andreitheclone/Voltage-Stabiliser/Layout/Layout.jpg

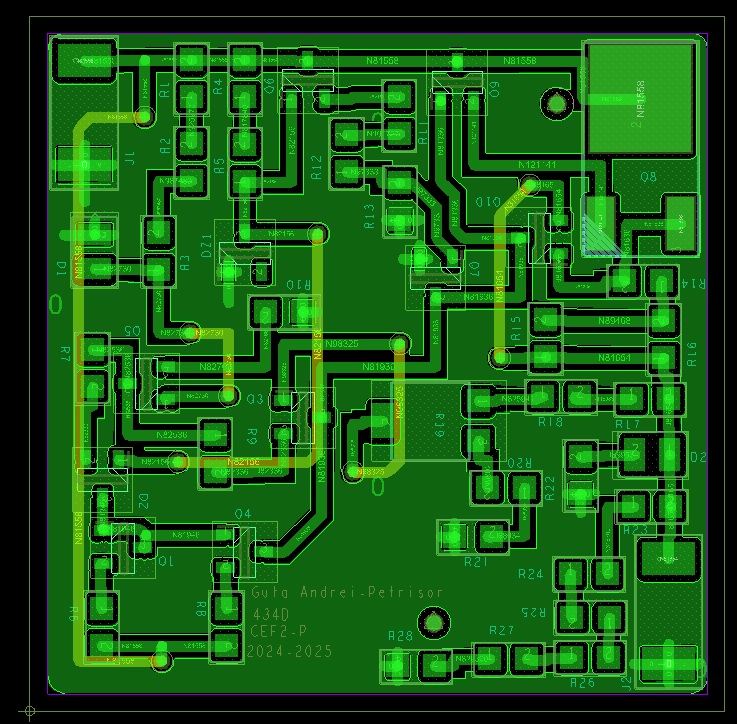
Layout/Layout.jpg
