andreitheclone/Voltage-Stabiliser/Proiect docs/Stabilizator de tensiune cu Element de Reglaj Serie.pdf

# Circuite electronice fundamentale 2 – Proiect Stabilizator de tensiune cu Element de Reglaj Serie (ERS)

Student: Guta Andrei-Petrisor Grupa: 434D

2024

## CUPRINS

1. Date initiale de proiectare
2. Schema bloc a montajului electric
3. Schema electrică a montajului
4. Simulări efectuate pentru a demonsta funcționarea schemei în parametrii impuși

### 1. Date initiale de proiectare

Tema proiectului: Se proiectează un stabilizator de tensiune cu element de reglaj serie cu următoarele caracteristici: N=13
- Tensiunea de ieșire reglabilă în intervalul: 6,5 - 13 [V]
- Element de reglaj serie;
- Sarcina la ieșire 520[Ω];
- Deriva termică < 2mV/⁰C;
- Protecție la suprasarcină prin limitarea temperaturii tranzistorului regulator serie la 120⁰C, si a curentului maxim la 0,5A;
- Tensiune de intrare în intervalul: 23,4 – 26 [V]
- Amplificarea în tensiune minimă (în buclă deschisă) a amplificatorului de eroare: minim 100;
- Domeniul temperaturilor de funcționare: 0⁰-60⁰C (verificabil prin testare în temperatură);
- Semnalizarea prezenței tensiunilor de intrare/ieșire cu diodă de tip LED.

### 2. Schema bloc a montajului electric

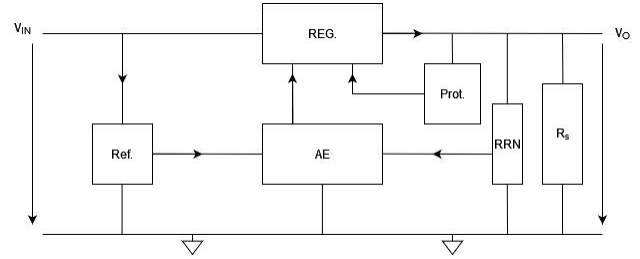
[picture p2: figure]

Ref. – Referința de tensiune
AE – Amplificatorul de eroare
REG. – Element reglaj serie
Prot. – Protecțiile la suprasarcină și termică RRN- Reacția negativă
RS- Impedanța de sarcină
- Referința de tensiune: Utilizeaza o diodă Zener pentru a stabiliza tensiunea de intrare, indiferent de diferiți parametri, cum ar fi sarcina, variațiile tensiunii de alimentare sau temperatura etc.
- Amplificatorul de eroare: Amplificatorul diferențial utilizează un amplificator neinversor cuplat la o oglinda de curent, care primește tensiunea de referință generate de dioda zenner pe intrarea neinversoare și o parte din tensiunea stabilizată pe intrarea inversoare prin intermediul retelei de reactie negativa.
- Reacția negativă: Reteaua de rezctie negative are rol in reglajul si mentinerea tensiunii de iesire. Primeste o parte din tensiunea de iesire pe care o redirectioneaza inapoi in amplificator pe intrarea inversoare. Pentru reglajul tensiunii de iesire este necesara utilizarea unui potentiometru.

- Element reglaj serie: Elementul reglaj serie este reprezentat de o punte Darlington formata din doua tranzistoare de putere care furnizează curent cu un anumit câștig către ieșire.
- Protectia termică și la suprasarcină: Asigură limitarea curentului și a temperaturii în intervalul de funcționare specificat

### 3. Schema electrică a montajului electric

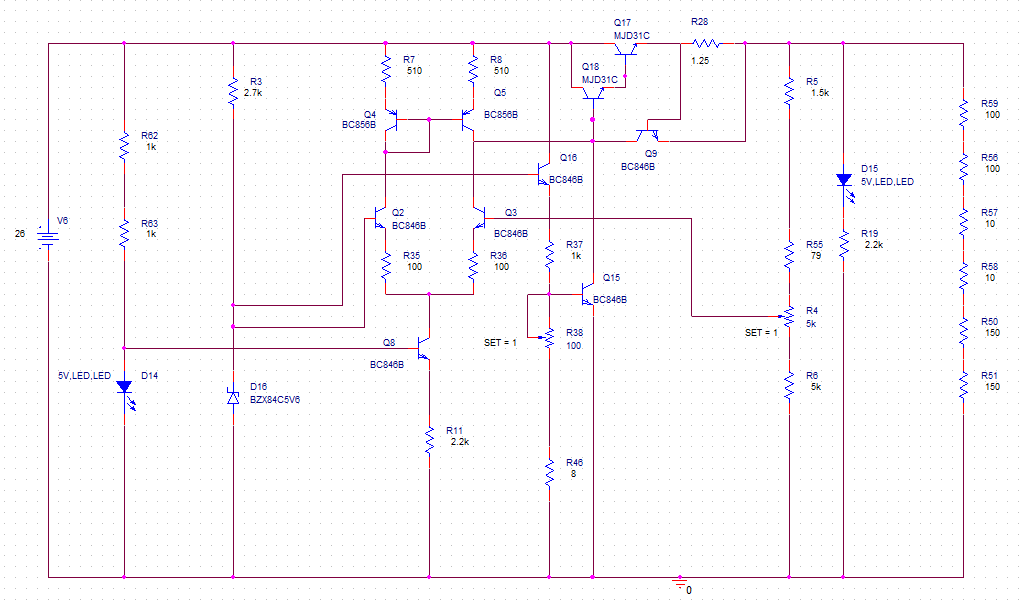
[picture p3: figure]

### 3.1. Conținut tehnic( calcul psf)

a. Referința de tensiune

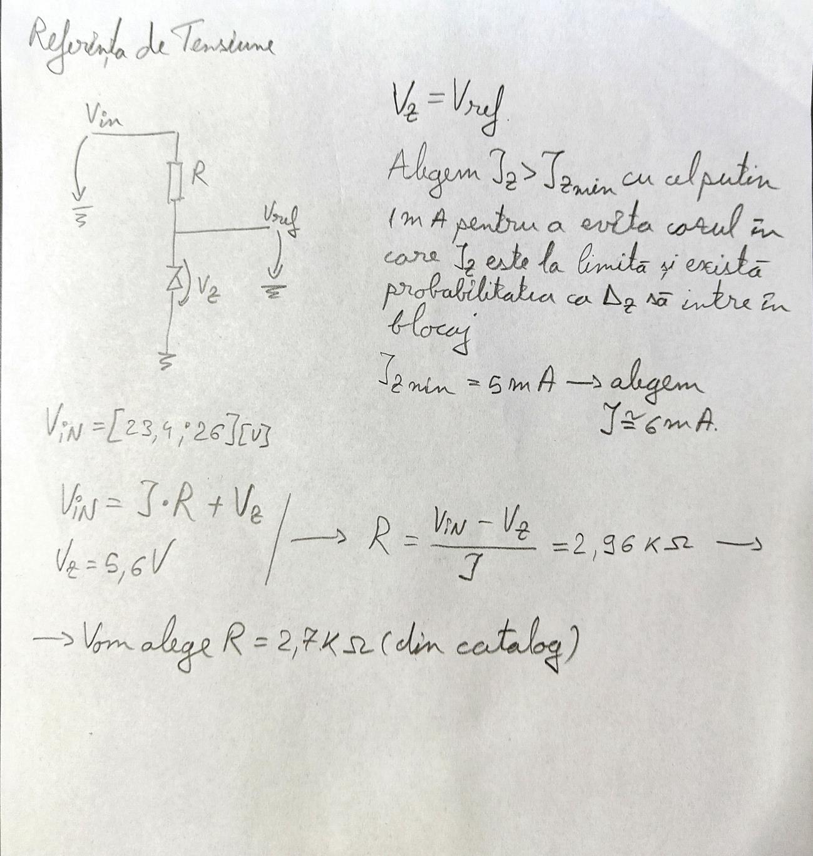
[picture p4: figure]

b. Amplificatorul de eroare

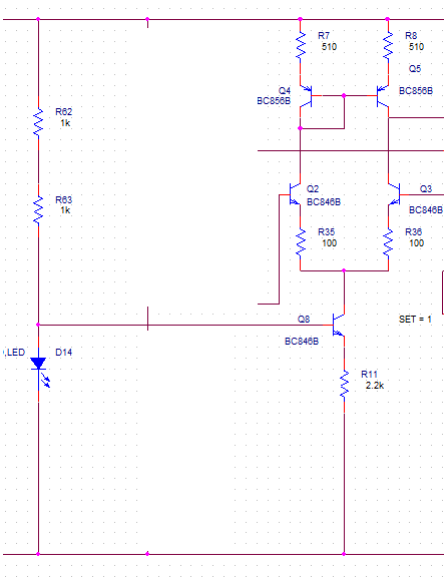
[picture p5: figure]

Amplificatorul de eroare are in componenta sa un generator de curent constant format din Q8, R62, R63 si D14(dioda led) vrea să tragă din amplificator un current de aproximativ 1 mA, astfel incat tranzistorul Q8 să funcționeze în RAN. IC2 + IC3 = IC8, dar VBE8 +R11*I=VD Rezultă R11=2.2kΩ. Se aleg tranzistoarele Q8, Q2 si Q3 de tip BC846B. Pentru echilibrul curenților din colectori IC2 și IC3, folosim oglinda de curent formată din Q4 și Q5 de tipul BC856B. Rezistorii R7 si R8 au rolul de a egaliza tensiunile baza-emitor a tranzistorilor din oglinda de curent realizată cu Q4 si Q5, de aceea R7 = R8 =510Ω.

c. Protecția la suprasarcină

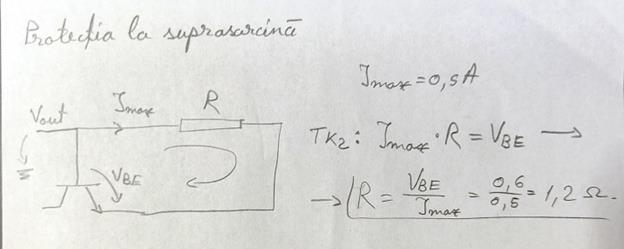
[picture p6: figure]

d. Reacția negative

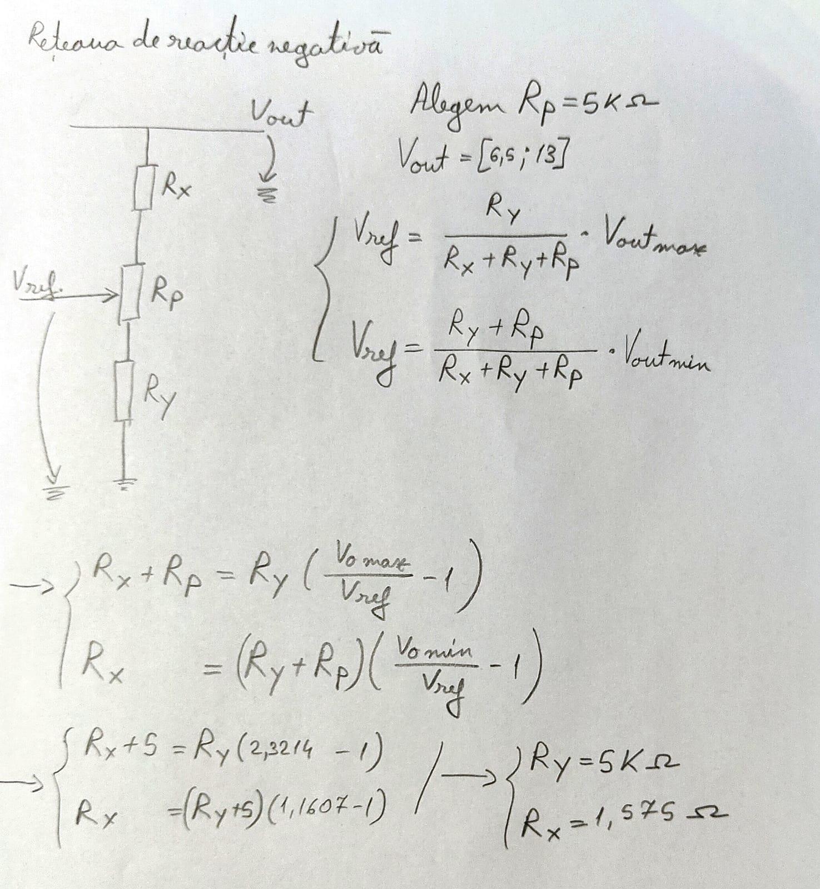
[picture p7: figure]

e. Element de reglaj serie

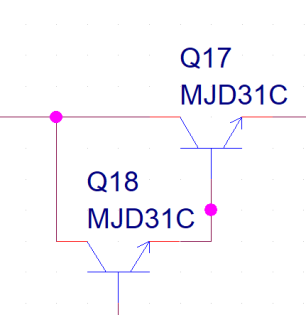
[picture p8: figure]

Utilizeaza doua tranzistoare de putere MJD31CG conectate in configuratie de punte Darlington.

### 3.2. Simulari PSF

Pentru a simula punctul static de funcționare se va ține cont de valorile tensiunilor de intrare 23.4-26V și de ieșire 6.5-13V, dar și de poziția potențiometrului (SET=0 sau SET=1). Astfel o să avem câte 4 tipuri de simulări pentru următoarele valori:

PSF- Tensiune
1. Vin=23.4 SET=0 Vout=13.00V

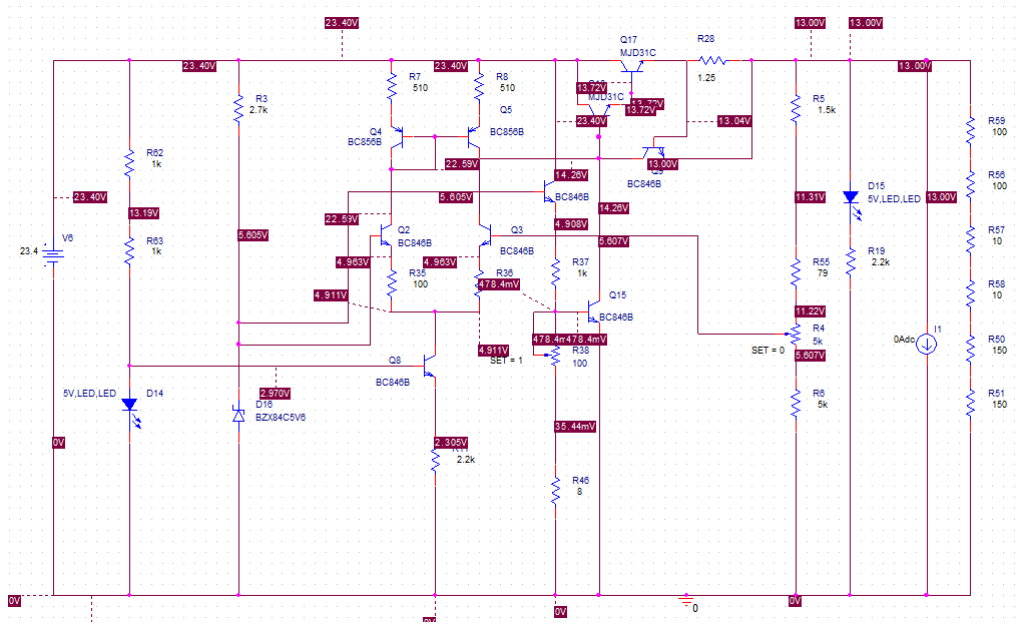
[picture p9: figure]
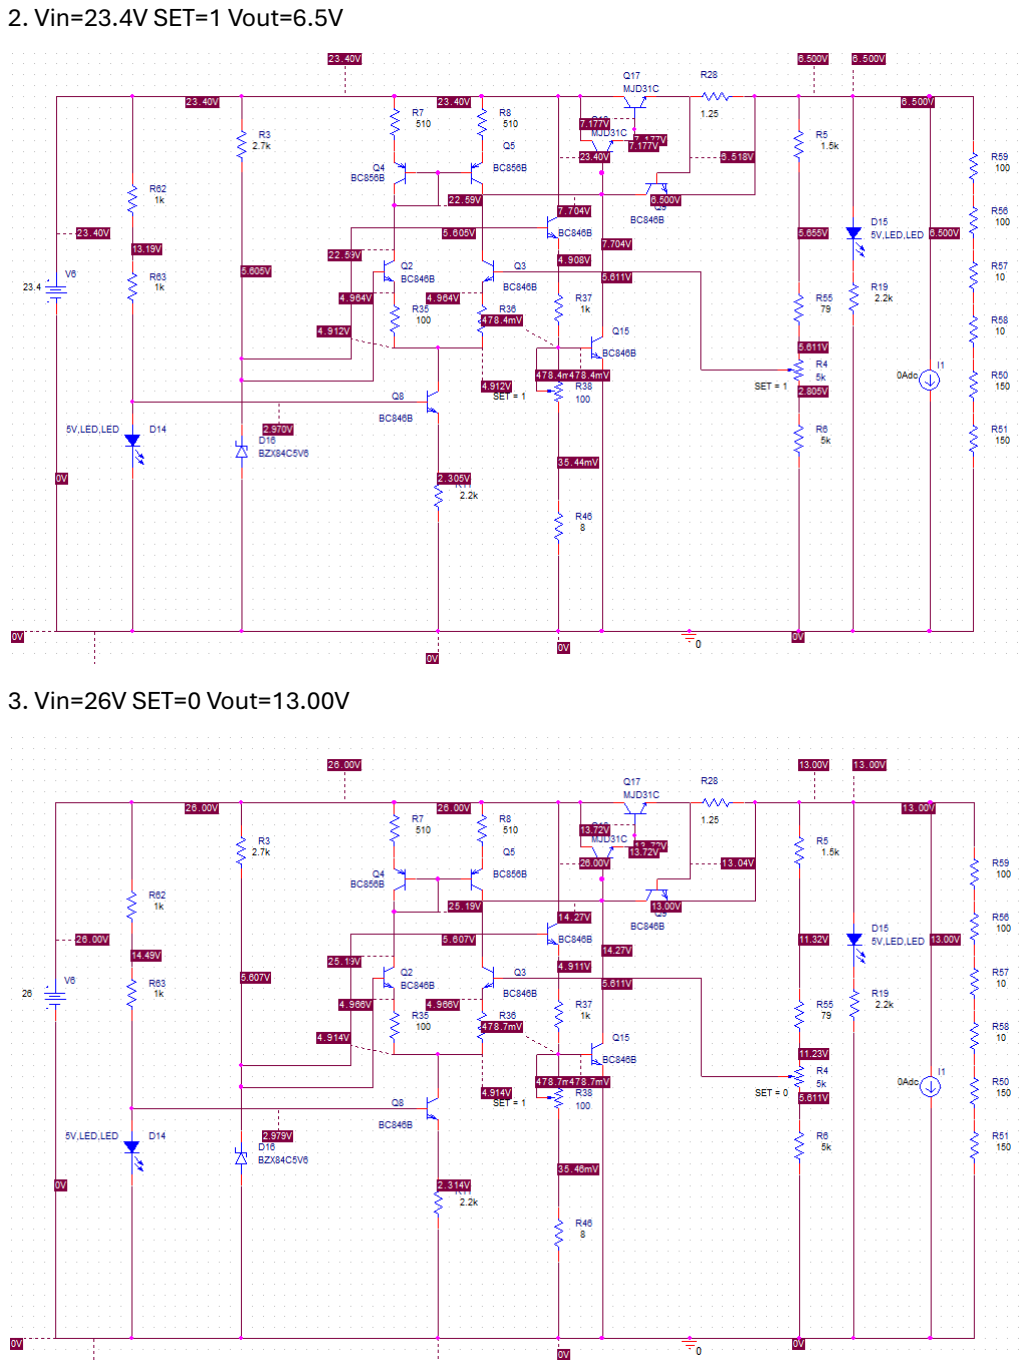
[picture p10: page 11]

2. Vin=23.4V SET=1 Vout=6.5V
3. Vin=26V SET=0 Vout=13.00V

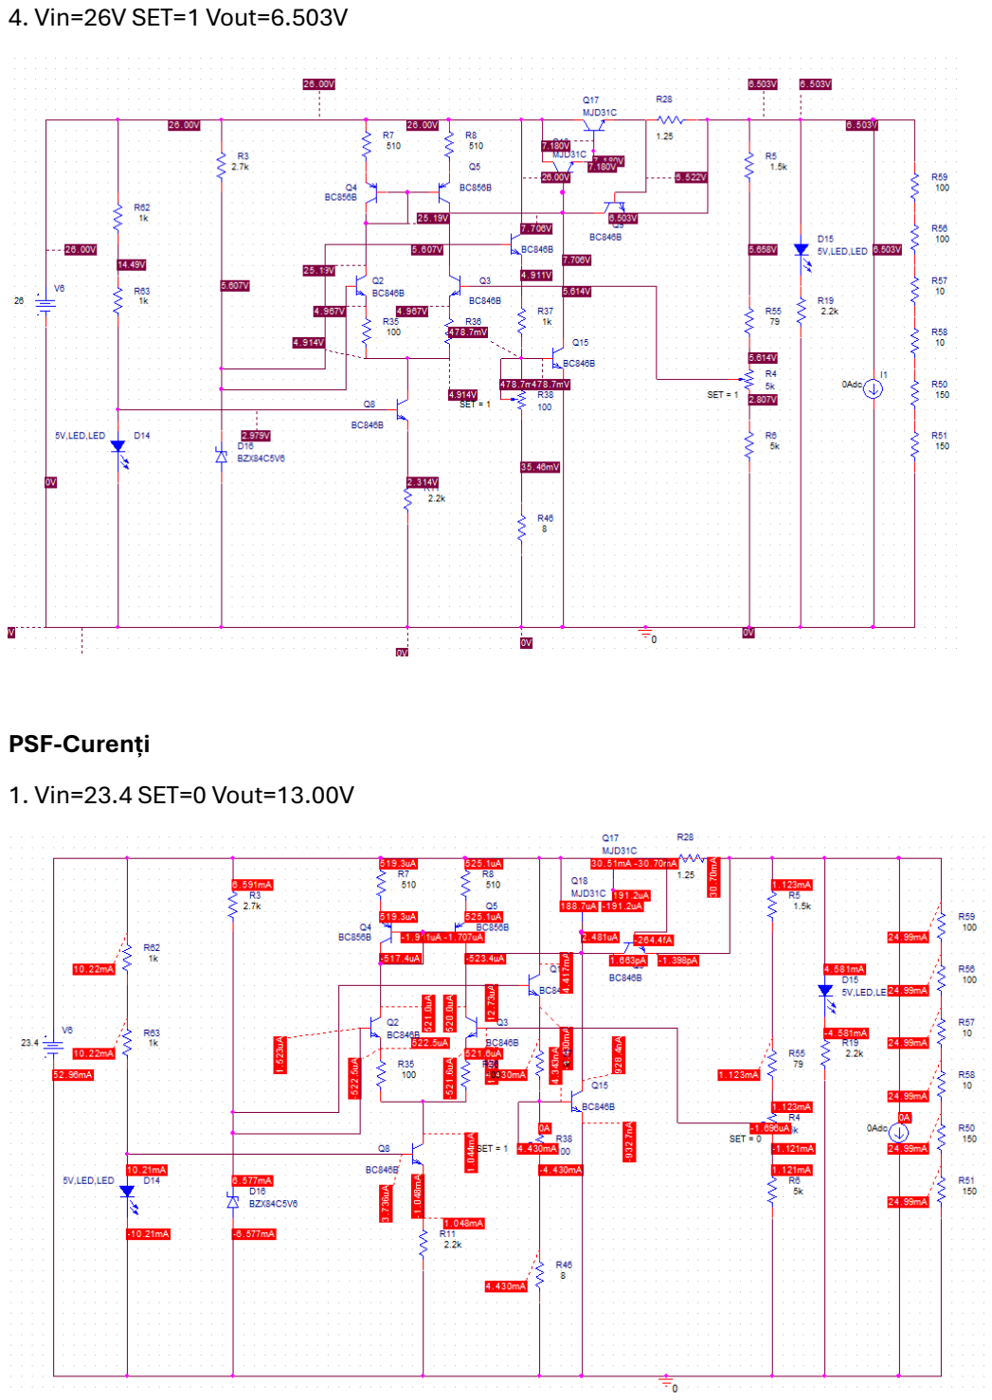
[picture p11: page 12]

4. Vin=26V SET=1 Vout=6.503V

PSF-Curenți
1. Vin=23.4 SET=0 Vout=13.00V

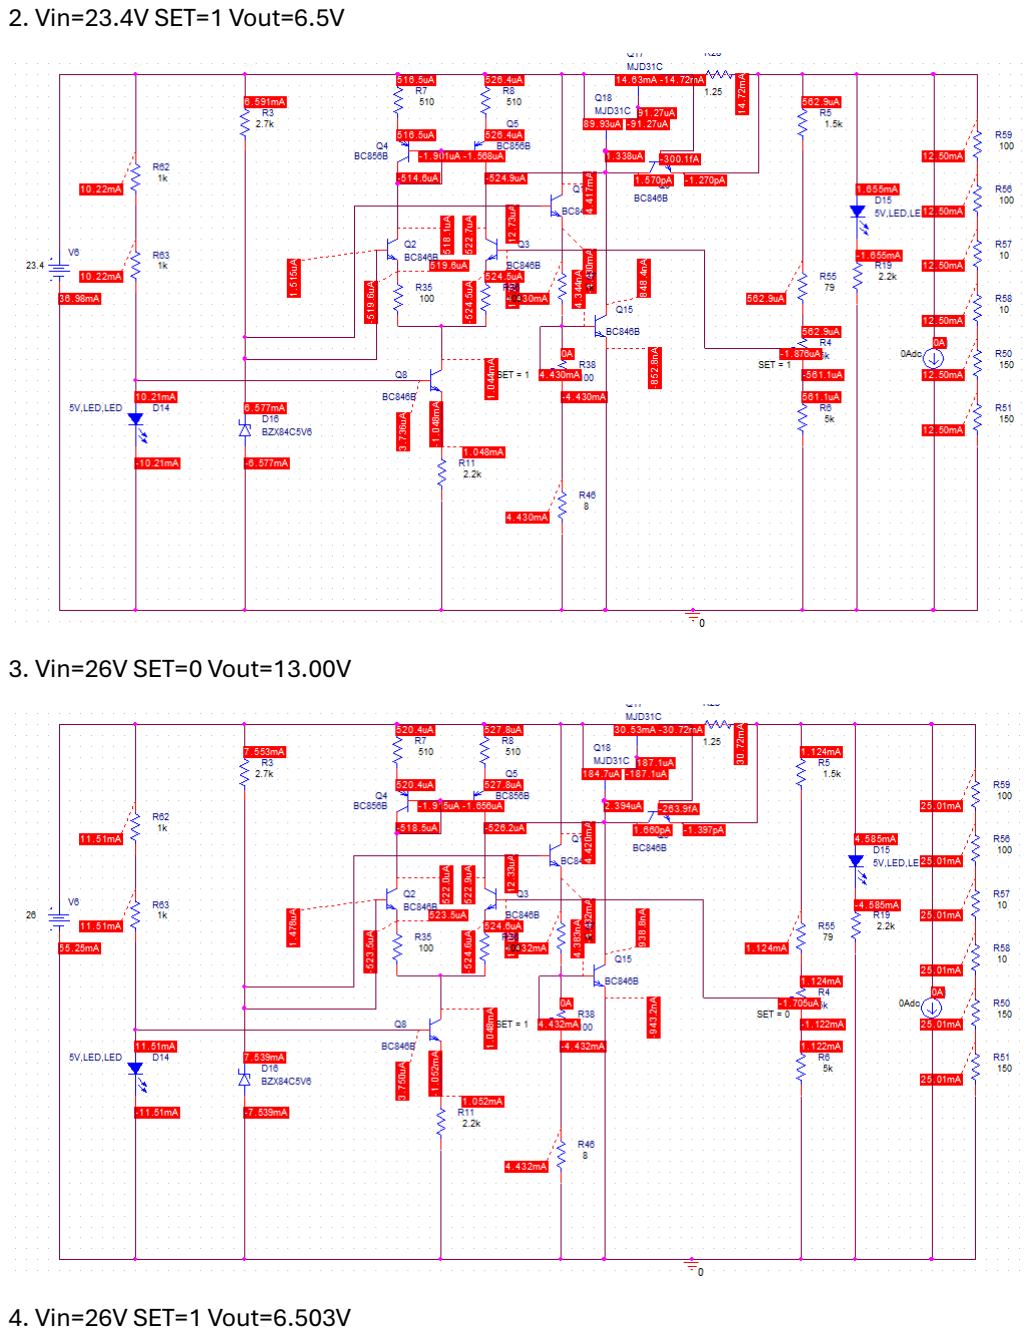
[picture p12: page 13]

2. Vin=23.4V SET=1 Vout=6.5V
3. Vin=26V SET=0 Vout=13.00V
4. Vin=26V SET=1 Vout=6.503V

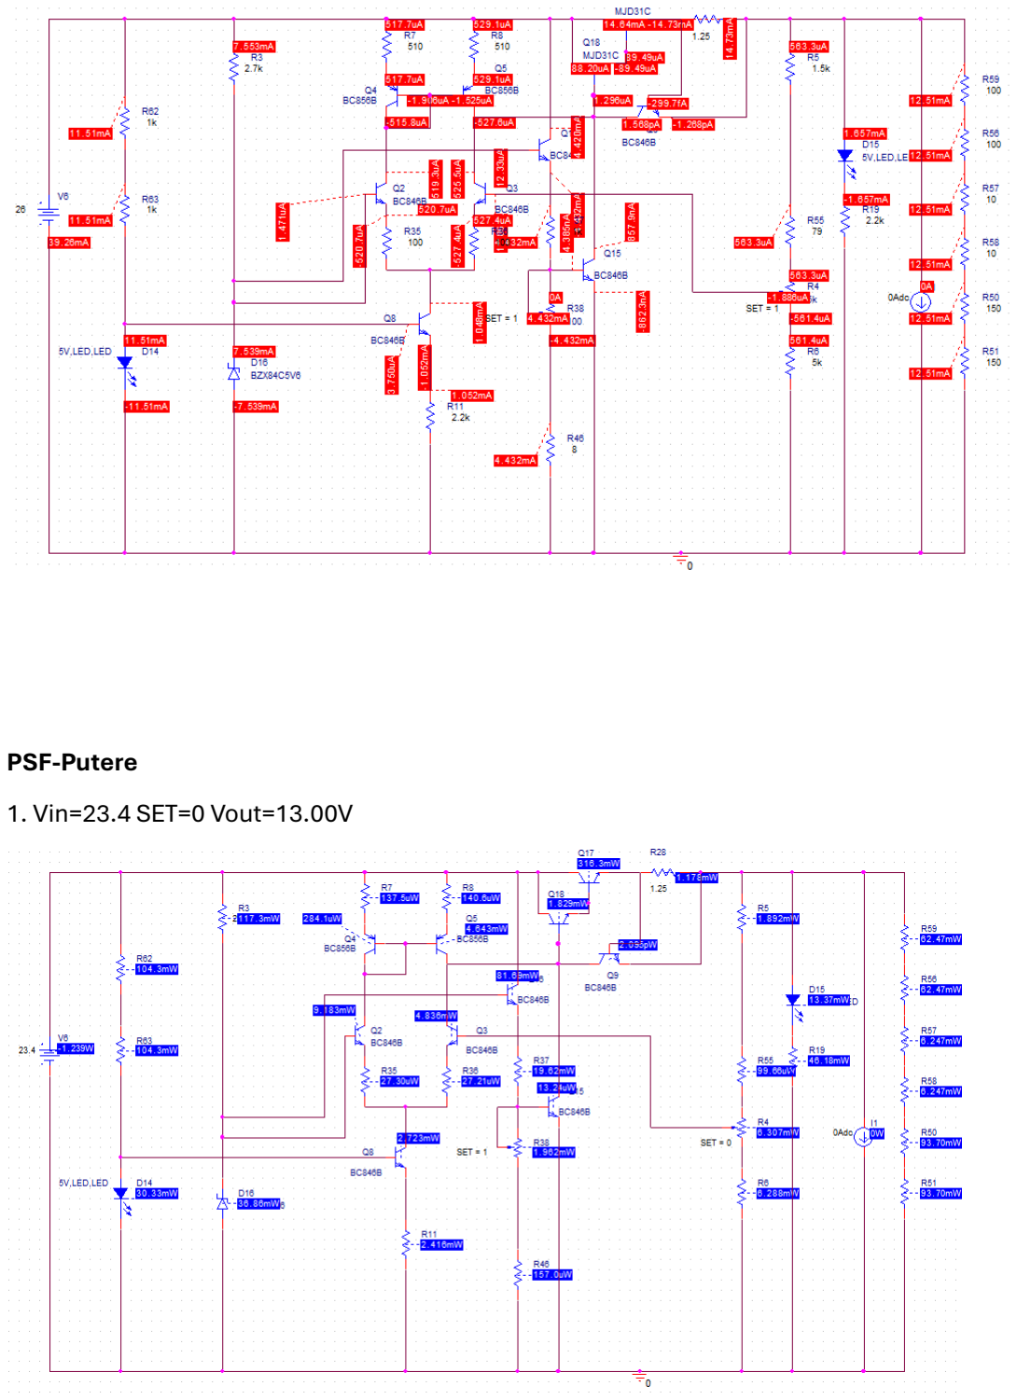
[picture p13: page 14]

PSF-Putere
1. Vin=23.4 SET=0 Vout=13.00V

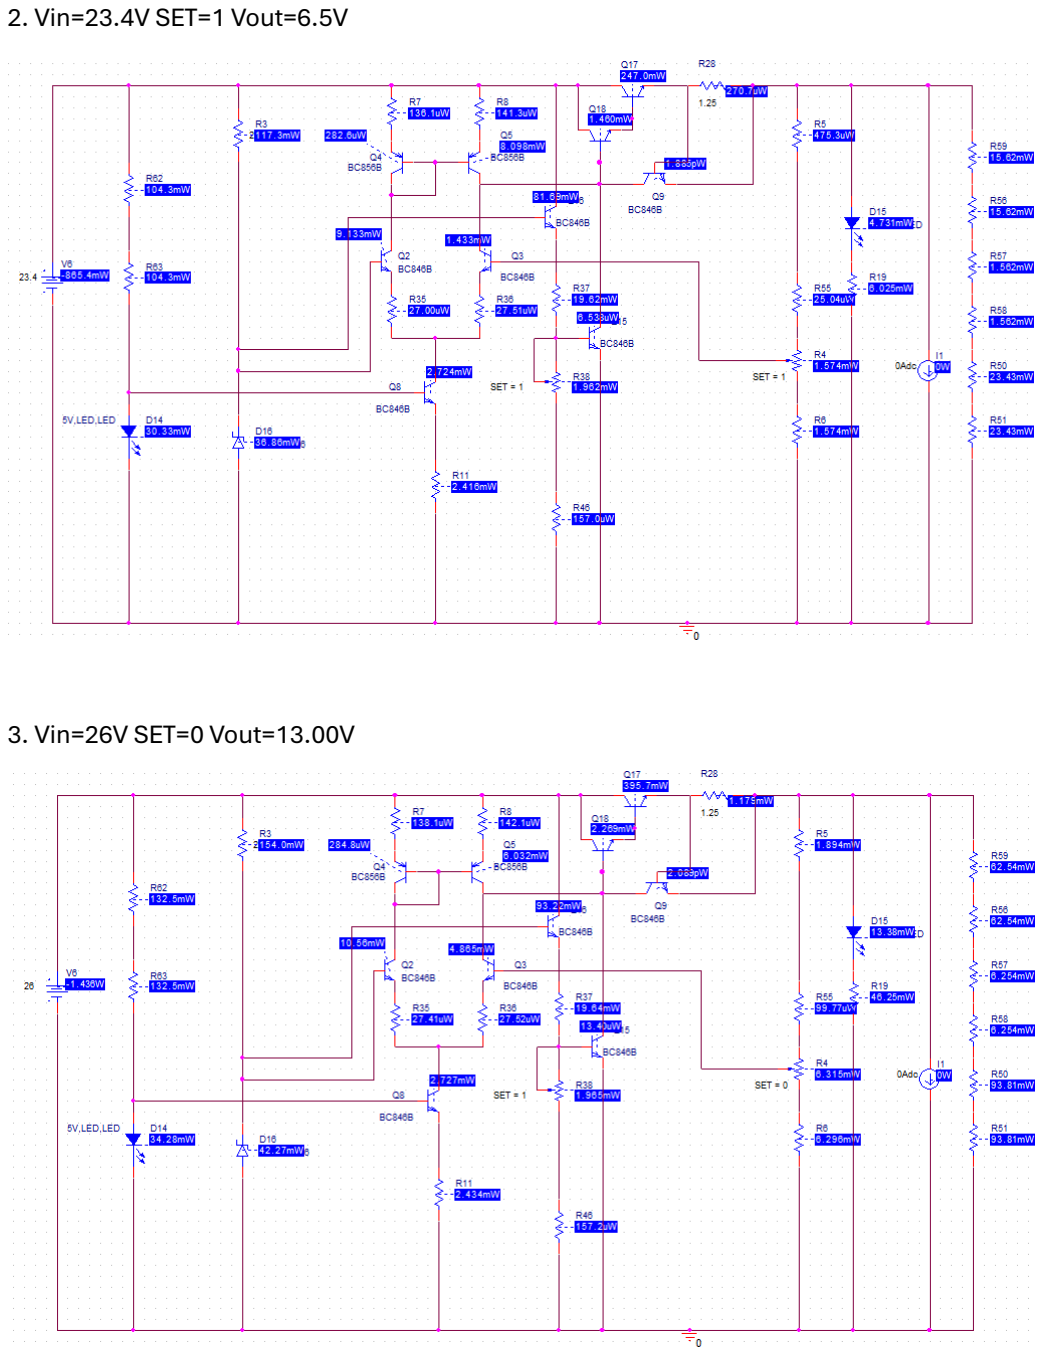
[picture p14: page 15]

2. Vin=23.4V SET=1 Vout=6.5V
3. Vin=26V SET=0 Vout=13.00V

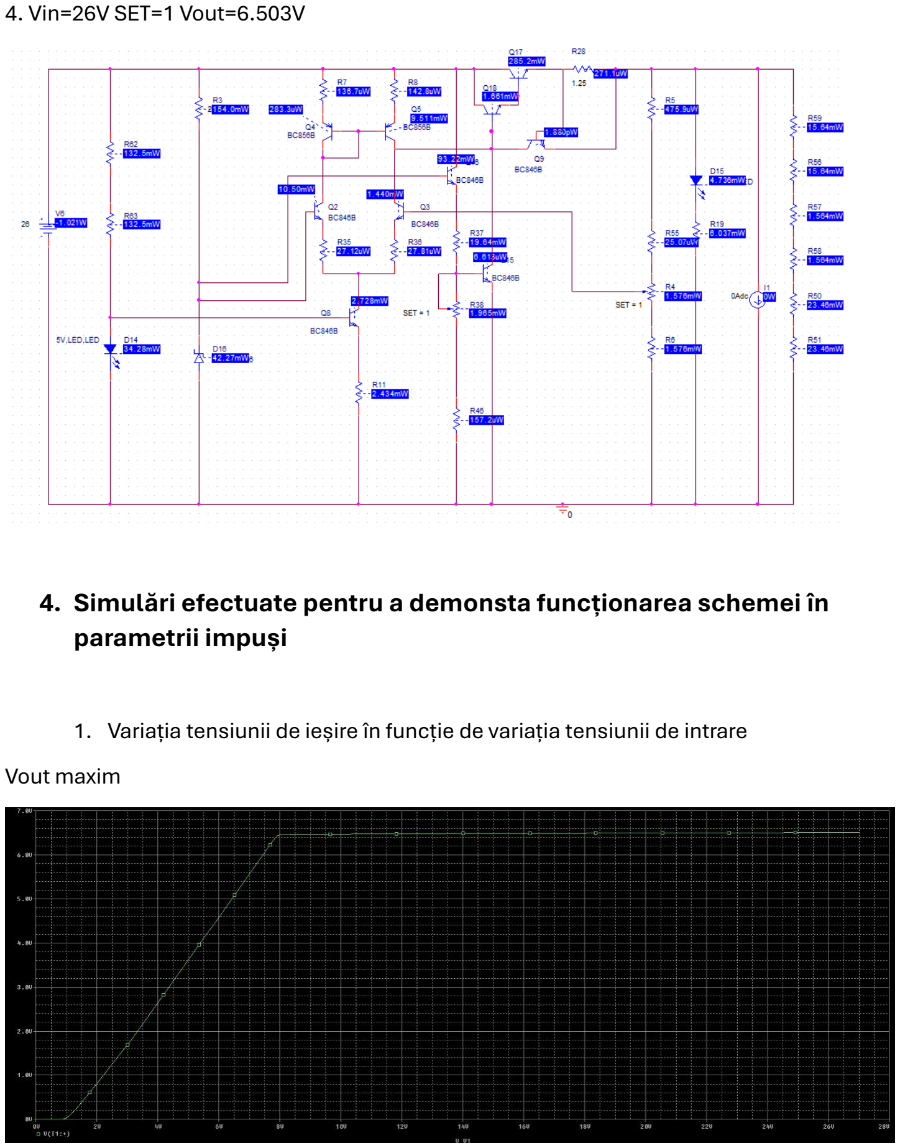
[picture p15: page 16]

4. Vin=26V SET=1 Vout=6.503V

### 4. Simulări efectuate pentru a demonsta funcționarea schemei în

parametrii impuși

1. Variația tensiunii de ieșire în funcție de variația tensiunii de intrare
Vout maxim

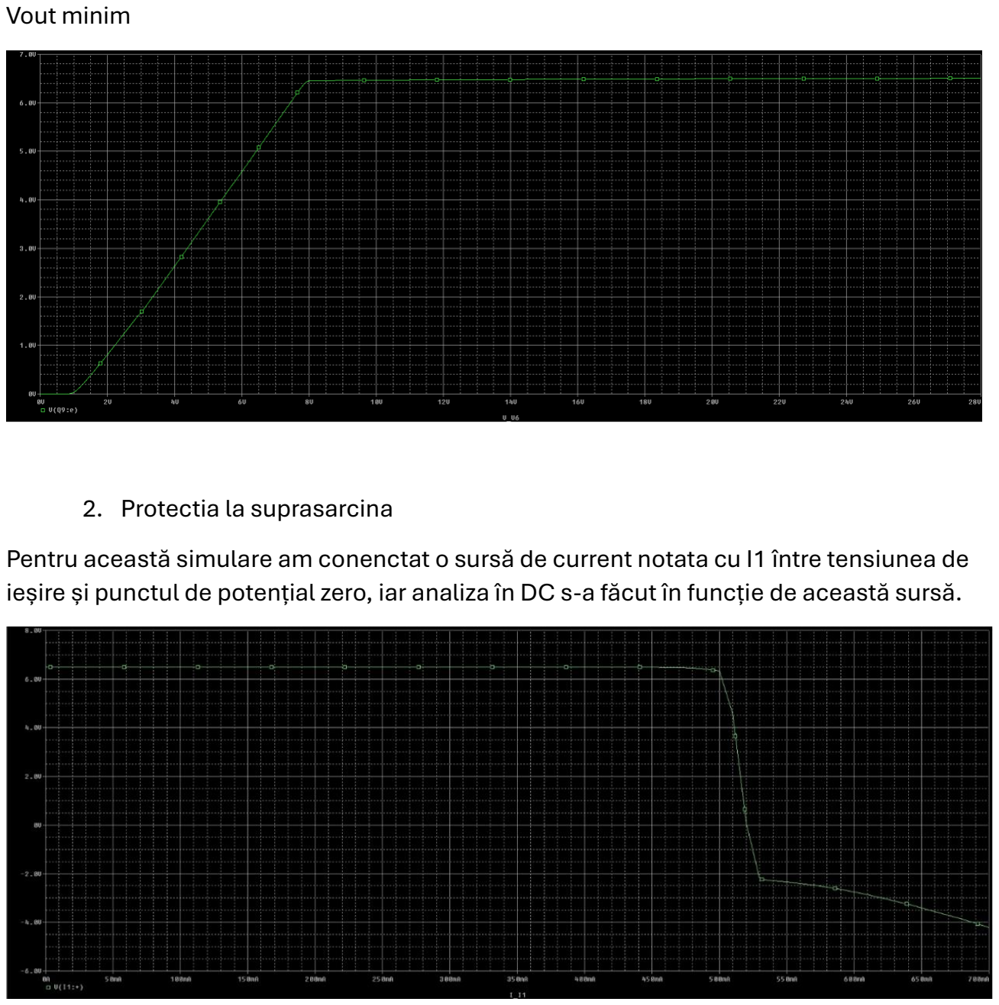
[picture p16: page 17]

Vout minim

2. Protectia la suprasarcina
Pentru această simulare am conenctat o sursă de current notata cu I1 între tensiunea de ieșire și punctul de potențial zero, iar analiza în DC s-a făcut în funcție de această sursă.

3. Protectia termica

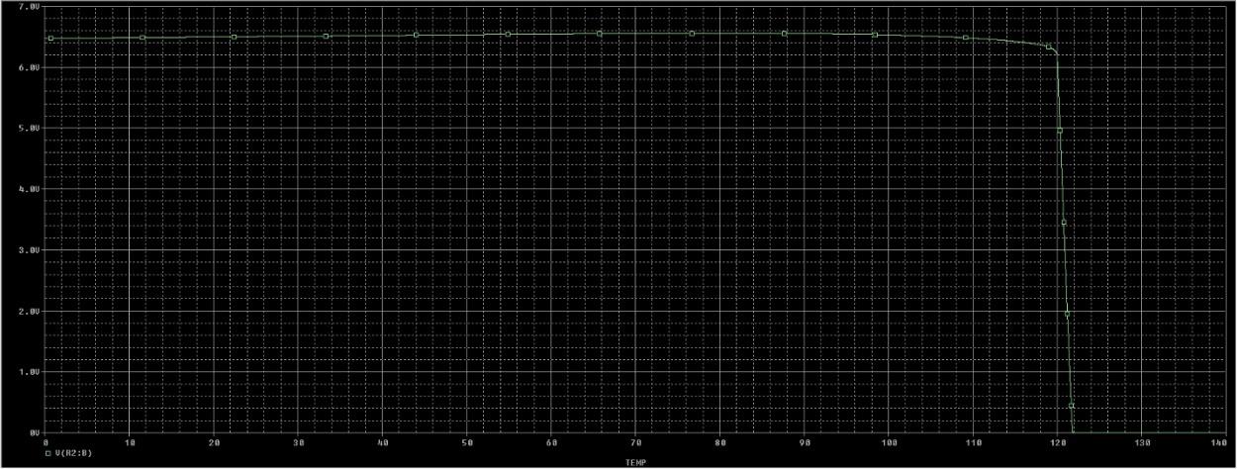
[picture p17: figure]

4. Amplificarea in bucla deschisa
Pe intrarea inversoare a amplificatorului se intrduce o sursa de AC si se izoleaza reteaua de reactie negativa. Vac=1V si se pune un pin de tensiune pe iesirea amplificatorului, rezultand graficul:

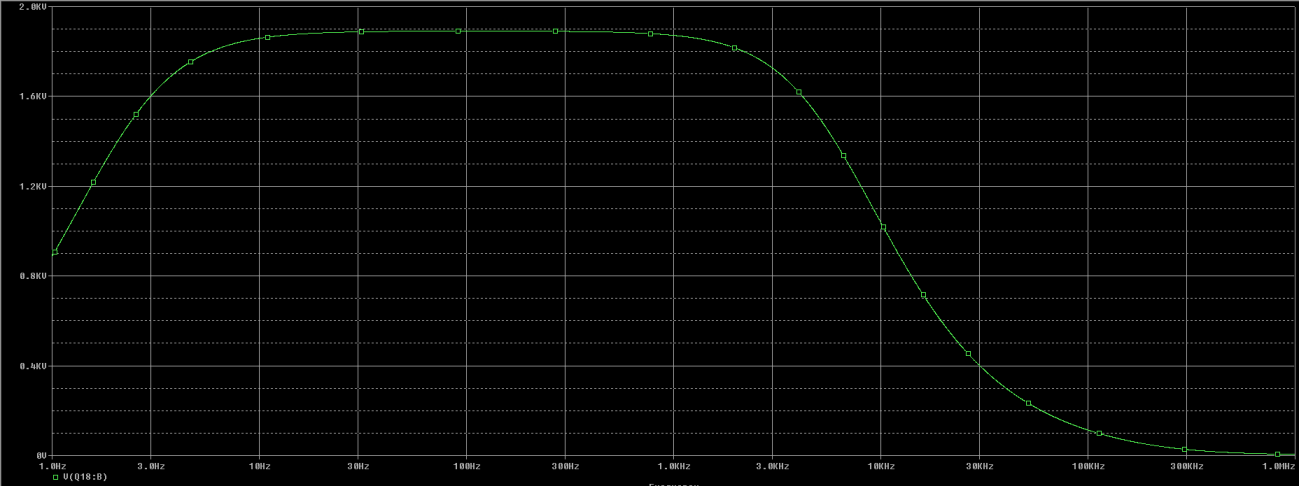
[picture p18: figure]

Bibliografie
Curs Circuite electronice fundamentale
Curs Circuite Integrate Analogice
Th. Danila, N. Reus, V. Boiciu, Dispozitive si circuite electronice, Editura didactica si pedagogica, Bucuresti – 1982

CODREANU N., PANTAZICĂ M., IONESCU C., MARCU A., “Tehnici CAD de realizarea modulelor electronice“, București, Editura CAVALLIOTI, 2017
Sursa curent continuu - https://www.nexperia.com/applications/sub-systems/constant-current-source (https://www.nexperia.com/applications/sub-systems/constant-current-source)
Amplificator diferential cu oglinda de current si sursa de cc -https://www.youtube.com/watch?v=pM3NTLv3xV4
