andreitheclone/Voltage-Stabiliser/schema_bloc.jpg

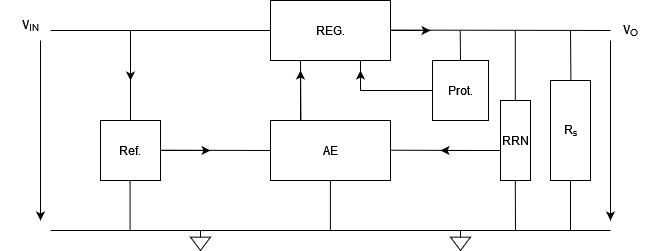
schema_bloc.jpg
