andreitheclone/Voltage-Stabiliser/Schematics/Schema electrica.jpg

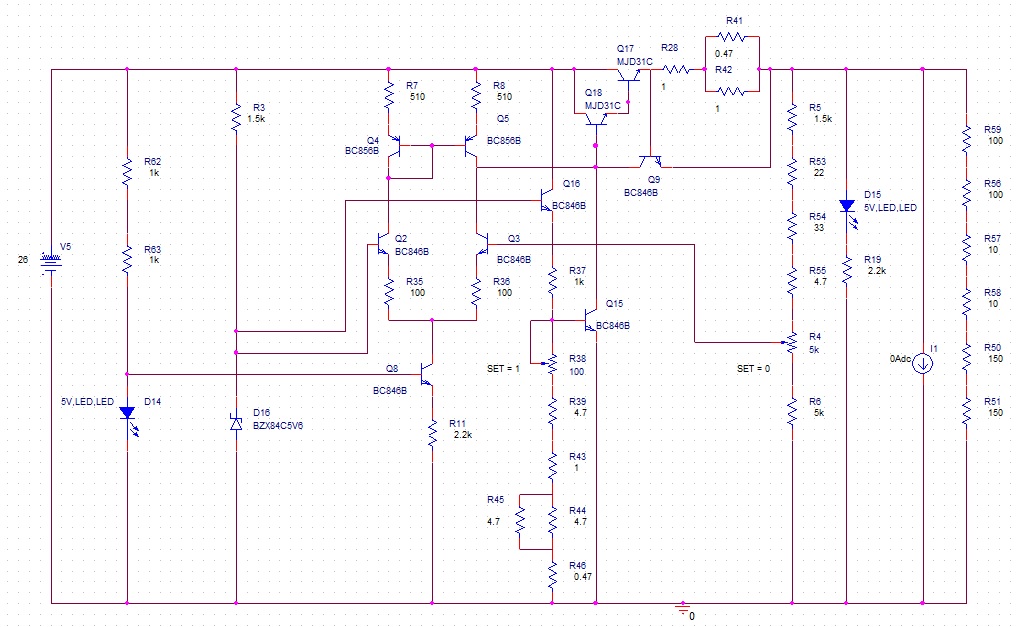
Schematics/Schema electrica.jpg
