andreitheclone/Voltage-Stabiliser/Simulations/Amplificare_bucla_deschisa.jpg

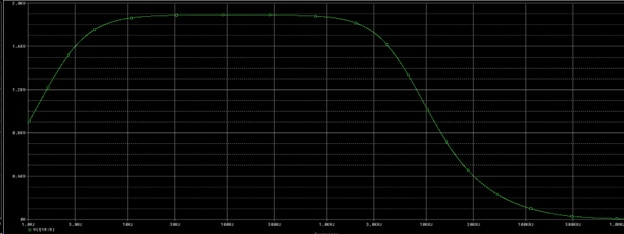
Simulations/Amplificare_bucla_deschisa.jpg
