andreitheclone/Voltage-Stabiliser/Simulations/Protectia_termica.jpg

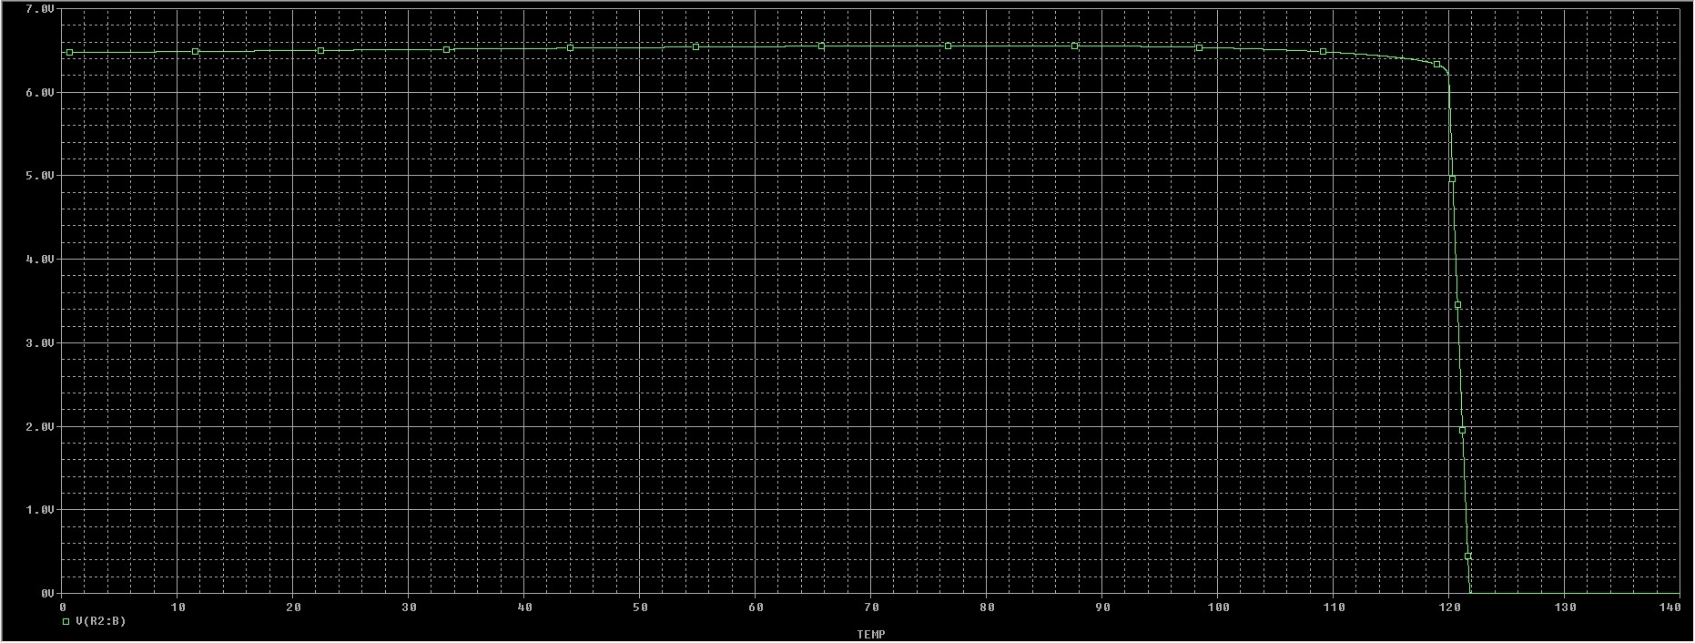
Simulations/Protectia_termica.jpg
