andreitheclone/Voltage-Stabiliser/Simulations/Protectie_suprasarcina.jpg

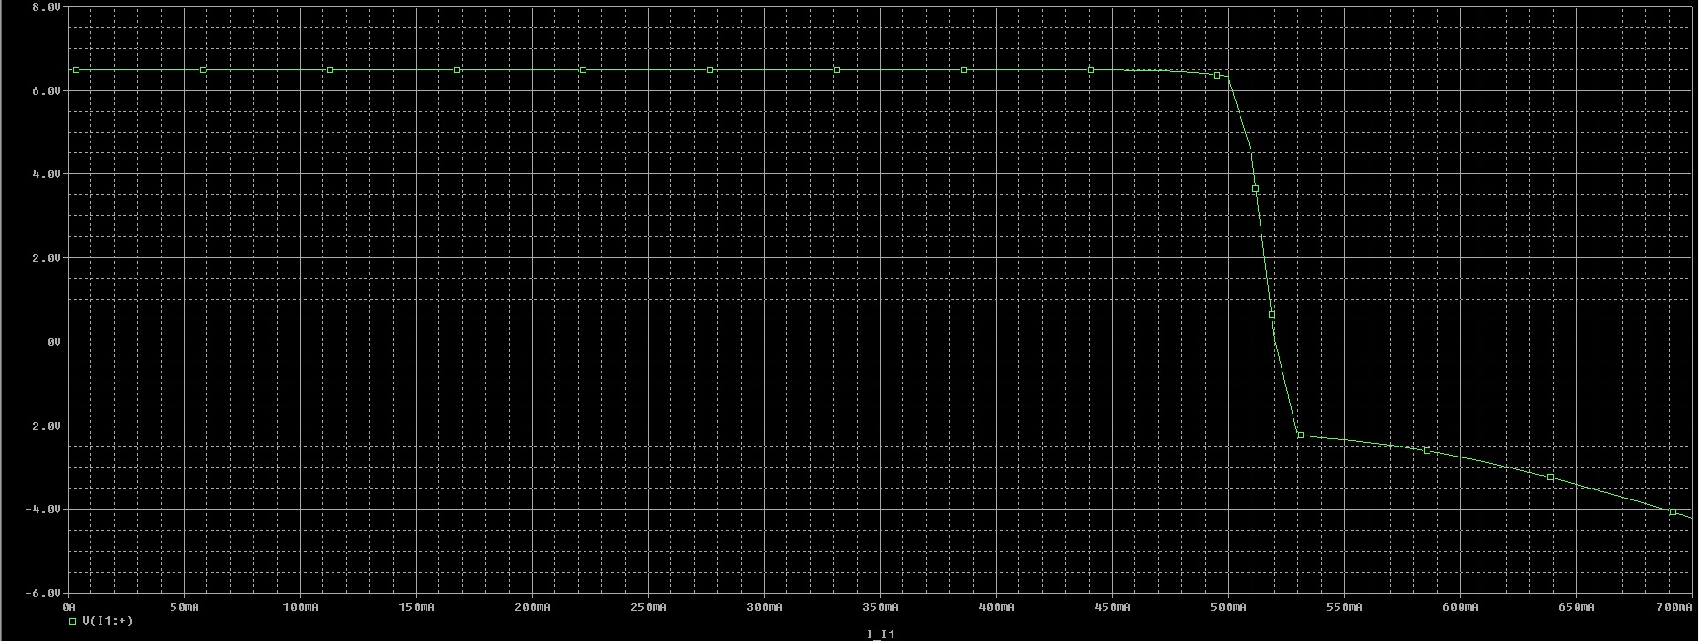
Simulations/Protectie_suprasarcina.jpg
