andreitheclone/Voltage-Stabiliser/Simulations/Simulare_stabilizare.jpg

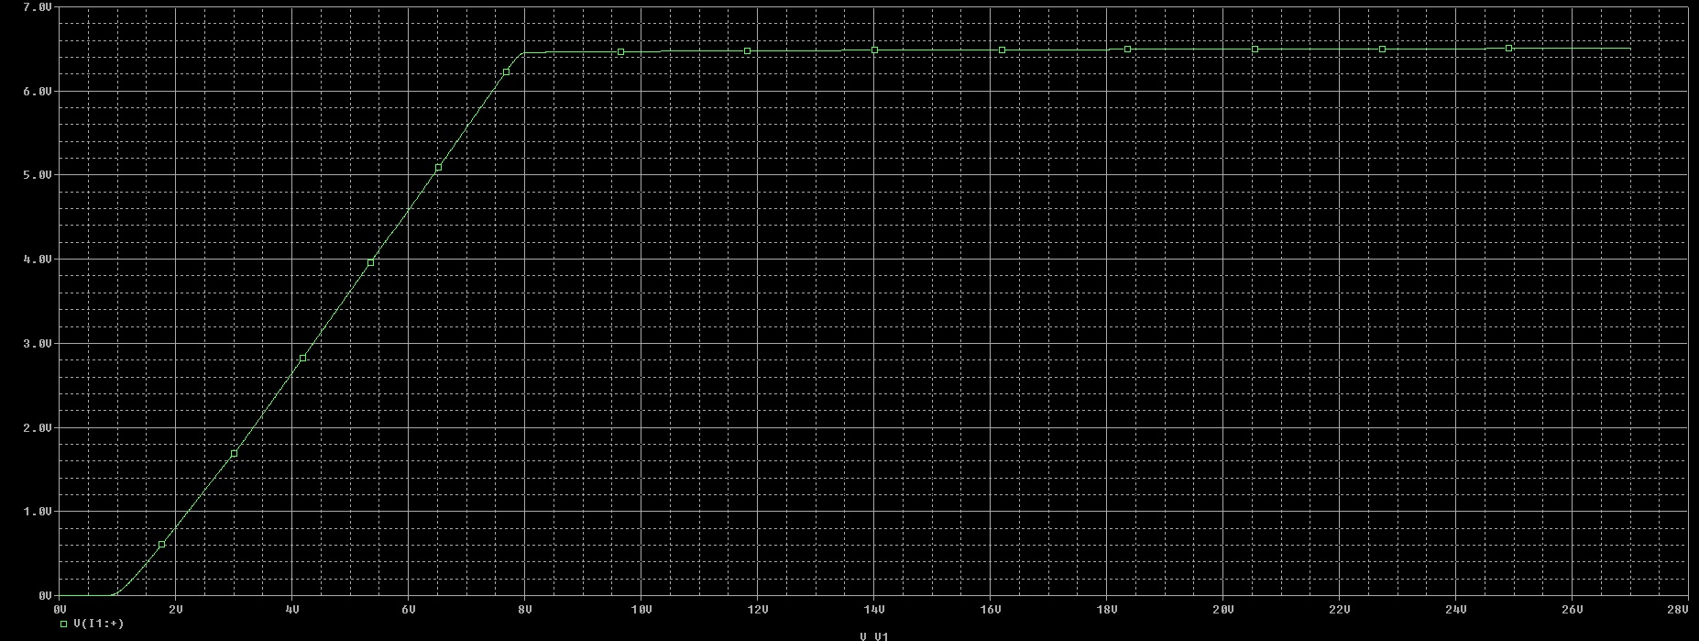
Simulations/Simulare_stabilizare.jpg
