andreitheclone/Voltage-Stabiliser/(list of files, drawings)

Other design files:
Schematics/proiect_cef2.dsn
Schematics/proiect_cef2.opj
