andreitheclone/Voltage-Stabiliser/Schematics/allegro/xsectionChartParams.txt

CHART_UNIT Millimeter
LAYER_NAME YES
LAYER_THICKNESS YES
LAYER_THICKNESS_TOL NO
MATERIAL_NAME NO
EMB_STATUS NO
ATTACH_METHOD NO
LAYER_TYPE YES
DRILL_SPAN YES
BACKDRILL_SPAN NO
STACKED_VIAS YES
EMD_COMP_LEGEND  NO
DRILL_LABEL  YES
X_SCALE_FACTOR  1.000
DIELECTRIC_SCALE_FACTOR  1.000
TEXT_BLOCK  1
MAX_CHART_HEIGHT 50.8 MM
