andreitheclone/Voltage-Stabiliser/Schematics/allegro/xsectionTableParams.txt

TABLE_TITLE: STACKUP TABLE
TABLE_UNIT= Millimeter
TABLE_LAYER_NAME YES
TABLE_STACKUP_THICKNESS YES
TABLE_LAYER_THICKNESS_TOL YES
TABLE_MATERIAL_NAME YES
TABLE_ZONE_NAME NO
TABLE_EMB_STATUS NO
TABLE_ATTACH_METHOD NO
TABLE_LAYER_TYPE YES
TABLE_DRILL_LABEL  YES
TABLE_TEXT_BLOCK  1
